chipnotic/open-amiga-sampler/classic-edition/design/open-amiga-samplerV1-1/Schematic.pdf

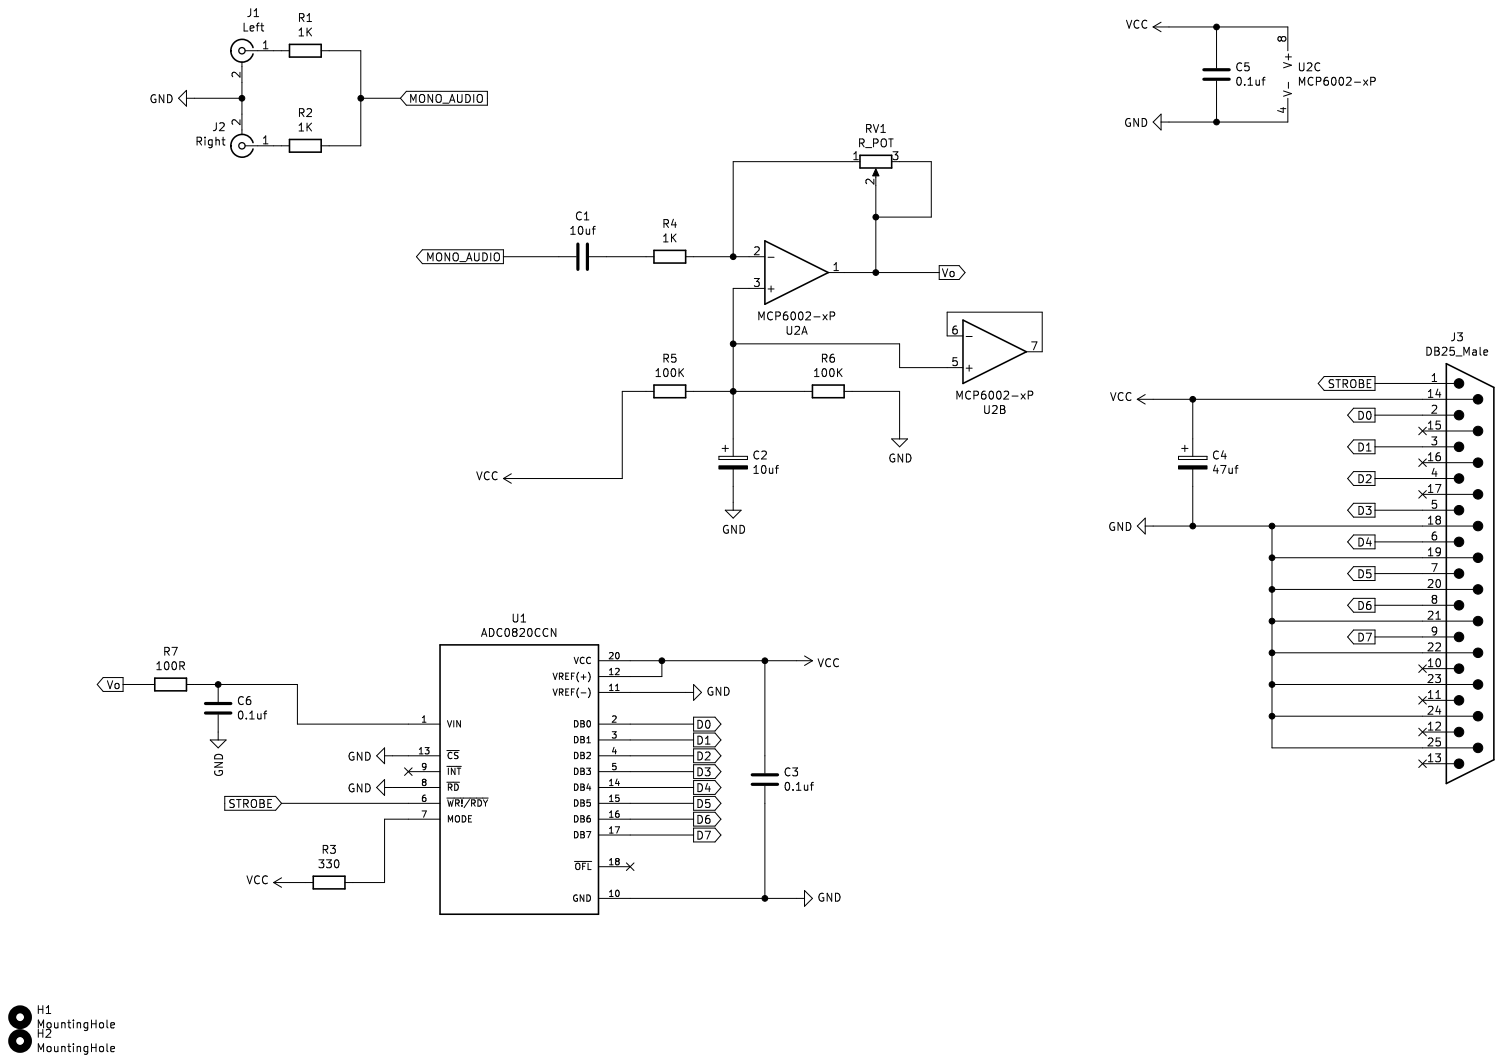
[picture p1: page 1]
