chipnotic/open-amiga-sampler/classic-edition/design/open-amiga-samplerV1-1/open-amiga-samplerV1-1.kicad_pcb

## KiCad design classic-edition/design/open-amiga-samplerV1-1/open-amiga-samplerV1-1.kicad_pcb (2022-03-19)

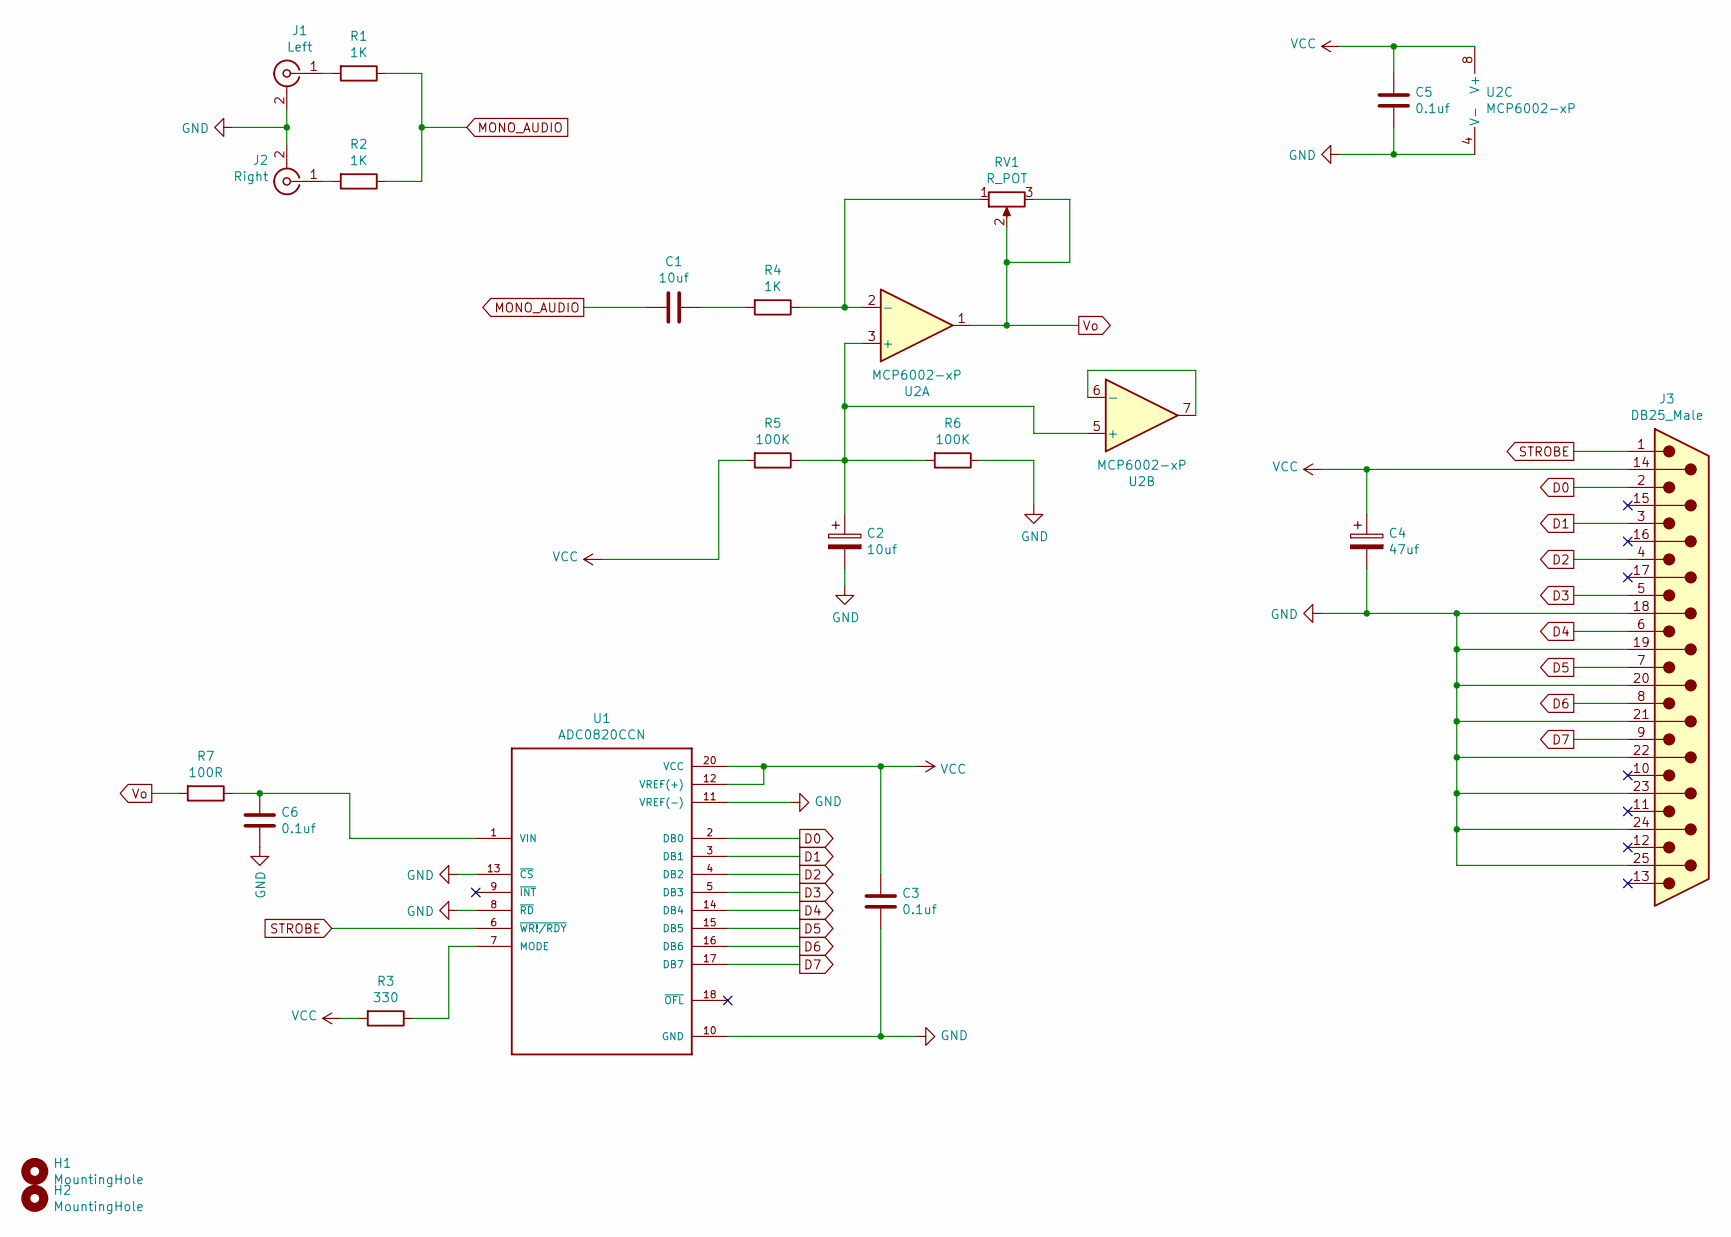
[picture p2: schematic open-amiga-samplerV1-1.kicad_sch]

Parts:
C1: 10uf; CP_Radial_Tantal_D5.5mm_P2.50mm; Mouser 581-TAP106K010DTW
C2: 10uf; CP_Radial_D4.0mm_P1.50mm; Mouser 647-UMP1A100MDD1TP
C3, C5, C6: 0.1uf; C_Disc_D3.4mm_W2.1mm_P2.50mm
C4: 47uf; CP_Radial_D5.0mm_P2.00mm; Mouser 647-URS1A470MDD1TA
H1, H2: MountingHole; MountingHole_2.2mm_M2
J1: Left; Audio pads; Mouser 490-RCJ-032
J2: Right; Audio pads; Mouser 490-RCJ-031
J3: DB25_Male; DSUB-25_Male_EdgeMount_P2.77mm; Mouser 601-40-9725M
R1, R2, R4: 1K; R_Axial_DIN0207_L6.3mm_D2.5mm_P10.16mm_Horizontal
R3: 330; R_Axial_DIN0207_L6.3mm_D2.5mm_P10.16mm_Horizontal
R5, R6: 100K; R_Axial_DIN0207_L6.3mm_D2.5mm_P10.16mm_Horizontal
R7: 100R; R_Axial_DIN0207_L6.3mm_D2.5mm_P10.16mm_Horizontal
RV1: R_POT; Pot pads; Mouser 858-P160KN-0QC20A10K
U1: ADC0820CCN; DIP-20_W7.62mm_Socket; Mouser 700-ADC0820CCN
U2: MCP6002-xP; DIP-8_W7.62mm_Socket; Mouser 579-MCP6002-I/P

Connections:
D0: J3.2, U1.2 (DB0)
D1: J3.3, U1.3 (DB1)
D2: J3.4, U1.4 (DB2)
D3: J3.5, U1.5 (DB3)
D4: J3.6, U1.14 (DB4)
D5: J3.7, U1.15 (DB5)
D6: J3.8, U1.16 (DB6)
D7: J3.9, U1.17 (DB7)
GND: C2.2, C3.2, C4.2, C5.2, C6.2, J1.2 (Ext), J2.2 (Ext), J3.18, J3.19, J3.20, J3.21, J3.22, J3.23, J3.24, J3.25, R6.1, U1.8 (~RD), U1.10 (GND), U1.11 (VREF(-)), U1.13 (~CS), U2.4 (V-)
MONO_AUDIO: C1.1, R1.1, R2.1
unnamed: C1.2, R4.2
unnamed: J1.1 (In), R1.2
unnamed: J2.1 (In), R2.2
unnamed: R3.1, U1.7 (MODE)
unnamed: R4.1, RV1.1, U2.2 (-)
unnamed: C6.1, R7.1, U1.1 (VIN)
unnamed: C2.1, R5.1, R6.2, U2.3 (+), U2.5 (+)
unnamed: U2.6 (-), U2.7
STROBE: J3.1, U1.6 (~WR!/RDY)
VCC: C3.1, C4.1, C5.1, J3.14, R3.2, R5.2, U1.12 (VREF(+)), U1.20 (VCC), U2.8 (V+)
Vo: R7.2, RV1.2, RV1.3, U2.1

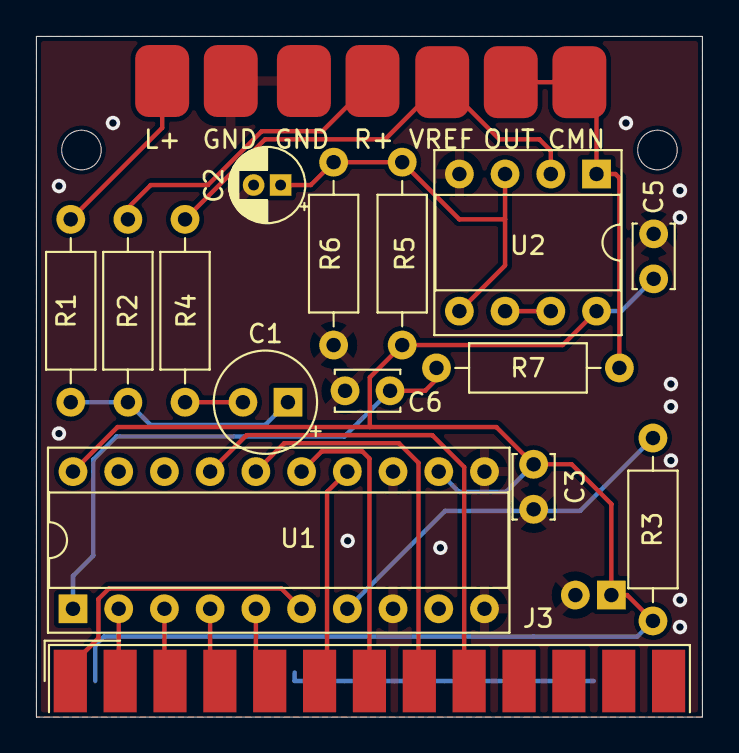
[picture p3: board open-amiga-samplerV1-1.kicad_pcb from above]

Board: 2 copper layers, 37.0 x 37.8 mm, 21 parts (1 on the bottom side), 21 nets.
