chipnotic/open-amiga-sampler/(commit log)

2022-03-19 Changes for V1.1
    Added changes to sampler as per gwEm303's V1.1 suggestions:
    DC Offset Fix - R5/R6 changed to 100k.
    C1 changed to tantalum.
    Connected unused op-amp.
    Added R7/C6 as "simple anti-aliasing filter (1st order)".
    PCB enlarged slightly to accommodate the new components, mounting holes not changed PCB just extended behind making the board slightly longer.
    C4 is mounted on rear and should be folded over.
    [open-amiga-samplerV1-1-B_Cu.gbr, open-amiga-samplerV1-1-B_Mask.gbr, open-amiga-samplerV1-1-B_Paste.gbr, open-amiga-samplerV1-1-B_Silkscreen.gbr, open-amiga-samplerV1-1-Edge_Cuts.gbr, open-amiga-samplerV1-1-F_Cu.gbr, open-amiga-samplerV1-1-F_Mask.gbr, open-amiga-samplerV1-1-F_Paste.gbr]
2022-03-19 File cleanup
    [open-amiga-sampler.kicad_pcb, open-amiga-sampler.sch]
